EmbeddedSystemClass/Digital-Storage-Oscilloscope-2018/README.md

# Digital-Storage-Oscilloscope-2018
## BOM file can be checked via /WORKSHOP/813927_PCB_ryuan2/Project Outputs for DSO/
