EmbeddedSystemClass/Digital-Storage-Oscilloscope-2018/WORKSHOP/Workshop 1 - LTSpice.pdf

# Workshop 1 - LTSpice and Front End Filter Design

# Introduction

In this workshop we will cover:

- Circuit simulation using SPICE
- LTSPICE tutorial
- 1

st and 2

nd order filter low-pass active and passive filter design
- Step parameter variation of a simulation
- Op-amp based DC offset circuitry
- Basic LTSpice power analysis

Learning objectives:

- To create schematics within LTSPICE
- To become familiar with simulation within LTSPICE
- To understand the importance of circuit simulation in the electronics system design cycle
- To experiment with circuit design in a simulated environment
- To begin understanding how you will design the digital oscilloscope (DSO) front-end subsystem

# LTSPICE Fundamentals

Some of you will be familiar with most features of LTSPICE. If so, feel free to continue onto the next section. However, we recommend that you skim through the following LTSPICE tutorials:

1. Basic (https://www.allaboutcircuits.com/technical-articles/basic-circuit-simulation-with-ltspice/)
2. Intermediate (https://www.allaboutcircuits.com/technical-articles/intermediate-ltspice-tutorial/)
3. Advanced (https://learn.sparkfun.com/tutorials/getting-started-with-ltspice)

# Simulating Filters

## Part A: 1

## st Order Filters

Construct the following low-pass first order passive and active op-amp filters and perform AC analysis between 1Hz and 100MHz with 100 points per decade.

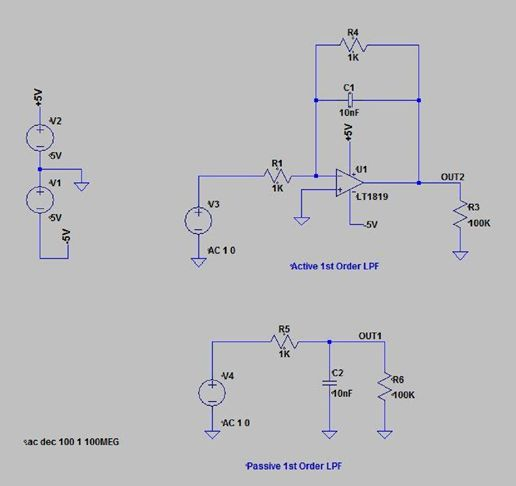
[picture p26: figure]

Figure 1: A Passive and Active 1st Order Low-pass Filter

### Questions

1. Given each filter has a -3dB roll-off frequency calculated by using the formulae found in appendix A, does the simulation agree with the value expected?
2. Does the passive and active frequency response differ and if so speculate why?
3. If the load is varied for both the active and passive circuit which circuit maintains greater gain stability?

## Part B: 2

## nd Order Filters

Using the steps outlined in appendix B and C design both a 2nd order Sallen-Key and Multiple-Feedback (MFB) op-amp filter design for simulation with LTSpice. The design parameters are as follows:

Roll-Off Frequency: f

-3dB = 100K
DC Gain: H0 | = 2
Use ⍺ = 1 | for the equations in appendix B and C. In lecture 5 you will cover filter design in detail.

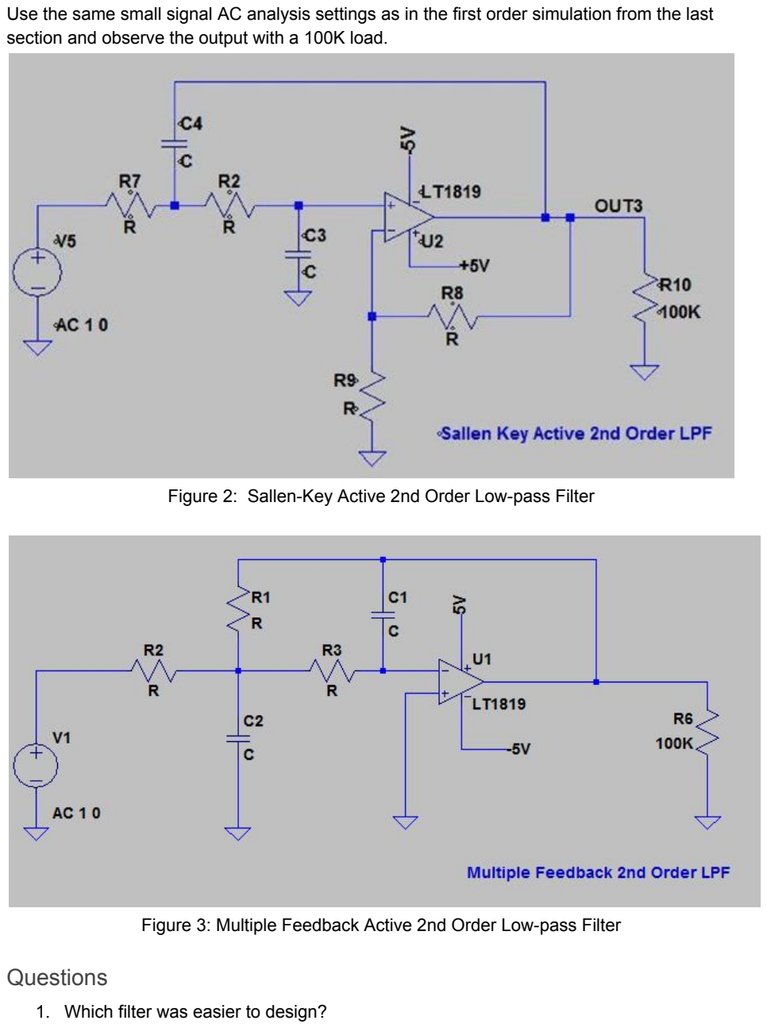
[picture p27: page 3]

Use the same small signal AC analysis settings as in the first order simulation from the last section and observe the output with a 100K load.

Figure 2: Sallen-Key Active 2nd Order Low-pass Filter

Figure 3: Multiple Feedback Active 2nd Order Low-pass Filter

### Questions

1. Which filter was easier to design?

2. Are the simulation results as expected?
3. If the capacitor C2 is varied in the MFB LPF what happens to the Q and corner frequency of the filter?
4. If the gain is varied for the Sallen-key 2nd order filter how is the frequency response changed?
5. If the load is varied for the MFB and Sallen-Key circuits which circuit maintains more stable frequency response and gain?

## Part C: Level Shifting Circuits

Now we seek to examine the performance of two level shifting circuits which achieve inverting and non-inverting DC voltage translation when an AC signal is applied to the input. Using a 2Vp-p input analyse the transient response at the output of each of the following circuits using varied DC voltage settings for sources V7 and V3.

Note the polarity of the DC reference is different for each level shifting topology.

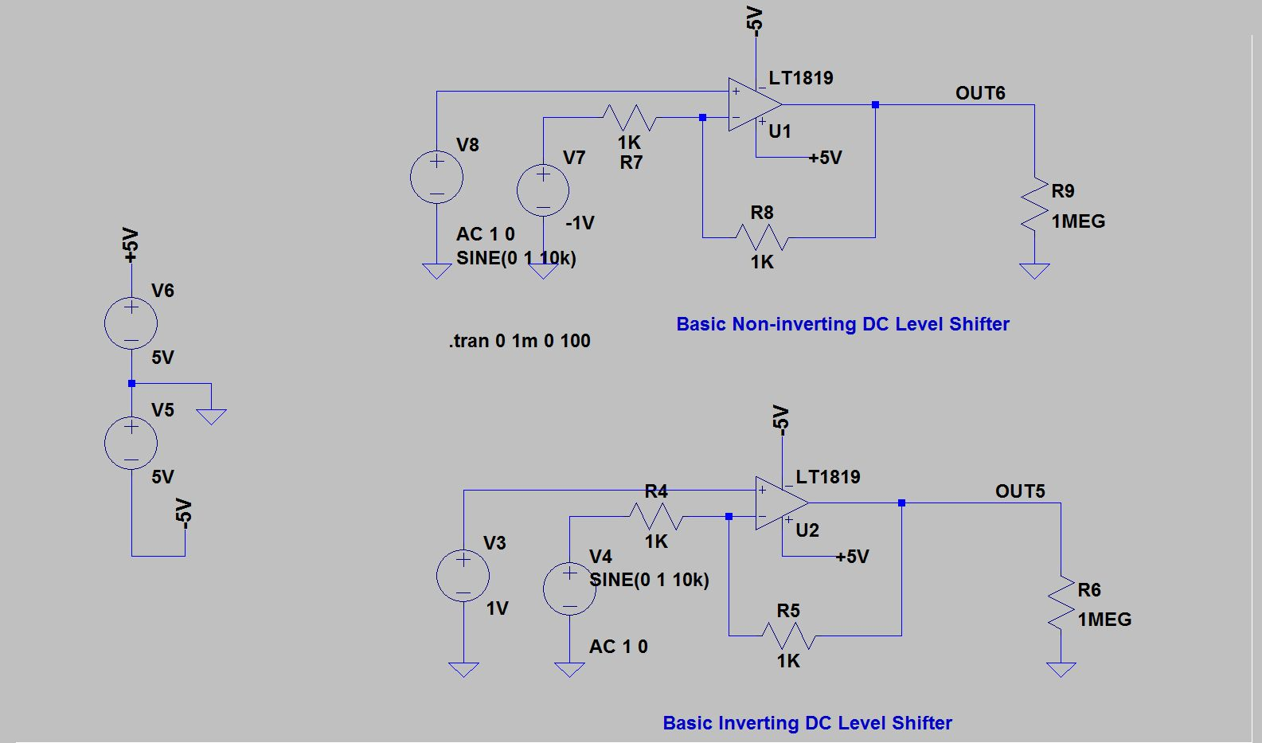
[picture p28: figure]

### Questions

1. What effect does changing the gain do to the level shifting function for a given DC reference voltage?
2. What change is observable for very low load resistance?
3. What is the output waveform for a pulse input signal? Does it differ from a pure sine?

4. What issues might arise if the DC reference is unable to sink high frequency currents through it?
5. How does the LT1819 simulation differ from an ideal opamp used in the same configuration?
6. Can you determine which component within the DC level shifter circuit is dissipating the greatest amount of power (as heat)
7. How might you reduce the power consumption of the level shifter circuit?

## Appendix A: 1

## st Order LPF Design

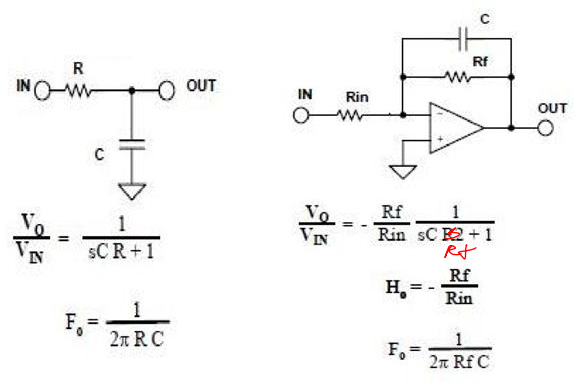
[picture p29: figure]

## Appendix B: 2

## nd Order Sallen-Key LPF Design

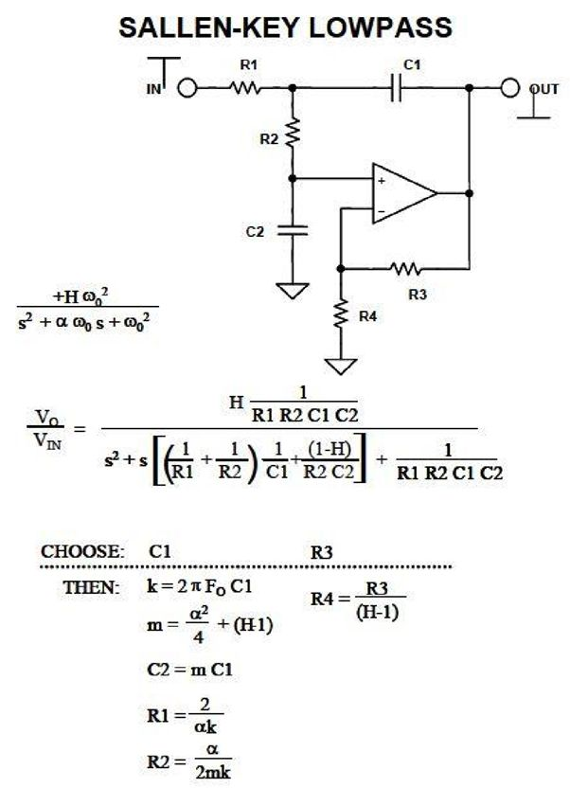
[picture p30: figure]

## Appendix C: 2

## nd Order Multiple Feedback LPF Design

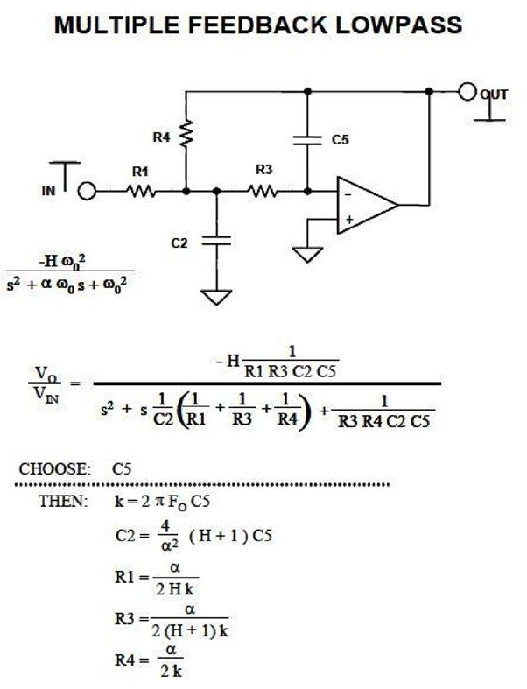
[picture p31: figure]
