EmbeddedSystemClass/Digital-Storage-Oscilloscope-2018/WORKSHOP/813927_PCB_ryuan2/Project Outputs for DSO/BOM/Bill of Materials-DSO.xlsx

Comment | Description | Designator | Footprint | LibRef | Manufacturer Part Number 1 | Quantity | Supplier Unit Price 1
5pf | Capacitor | C1, C3 | 0805C | C |  | 2
18pF | Capacitor | C2, C27, C28 | 0805C | C |  | 3
4.7pF | Capacitor | C4 | 0805C | C |  | 1
10uF | Capacitor | C5, C10, C11, C16, C48, C50 | 0805C | C |  | 6
100nF | Capacitor | C6, C8, C9, C12, C13, C14, C15, C17, C18, C19, C20, C21, C22, C23, C24, C25, C26, C29, C30, C31, C32, C33, C34, C35, C36, C37, C38, C39, C40, C41, C42, C43, C44, C45, C46, C47, C49, C51, C52, C53, C54, C55 | 0805C | C |  | 42
47pf | Capacitor | C7 | 0805C | C |  | 1
1uF | Capacitor | C56, C57 | 0805C | C |  | 2
Diode | Diode | D1, D2 | SOD-123 | D |  | 2
TX | Light Emitting Diode | D3, D5, D7 | 0805D-GREEN | LED GREEN | LTST-C171GKT (https://octopart-clicks.com/click/altium?sku=160-1423-1-ND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) | 3 | 0.34
RX | Light Emitting Diode | D4, D6 | 0805D-RED | LED RED | LHR974-LP-1 (https://octopart-clicks.com/click/altium?sku=475-1415-1-ND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) | 2 | 0.36
INPUT | BNC Straight | J1 | BNC_VERT | BNC | 5-1634503-1 (https://octopart-clicks.com/click/altium?sku=A97581-ND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) | 1 | 1.73
JTAG | JTAG_CON | J2 | BOXEDVERT10 | JTAG_CON | XG4C-1031 (https://octopart-clicks.com/click/altium?sku=OR896-ND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) | 1 | 1.04
USB | USB B Type Connector | J3 | USBPLUG | USBPLUG | 61729-0010BLF (https://octopart-clicks.com/click/altium?sku=609-1039-ND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) | 1 | 1.16
300mA | Inductor | L1, L2, L3, L4 | 0805 | I |  | 4
Header 3x2 | Header, 5-Pin | P1, P2 | HDR3x2 | Header 3x2 | M20-9980346 (https://octopart-clicks.com/click/altium?sku=952-2121-ND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) | 2 | 0.24
RTR025N03TL | N-Channel MOSFET | Q1, Q2, Q3 | SOT23 | MOSFET-N |  | 3
510k | Resistor | R1, R4 | 0805 | R |  | 2
1k | Resistor | R2, R3, R13, R16, R17, R18, R19, R20, R21, R22, R23, R24, R25, R26 | 0805 | R |  | 14
100K | Resistor | R5, R12 | 0805 | R |  | 2
100 | Resistor | R6, R7 | 0805 | R |  | 2
301 | Resistor | R8 | 0805 | R |  | 1
39 | Resistor | R9 | 0805 | R |  | 1
50 | Resistor | R10 | 0805 | R |  | 1
330 | Resistor | R11, R27 | 0805 | R |  | 2
10k | Resistor | R14, R15 | 0805 | R |  | 2
120 | Resistor | R28, R29, R30, R31 | 0805 | R |  | 4
RESET | Momentary Push Button Switch 1P 1T 2pins | S1, S2 | SPST PB SWITCH SMD | SW_PB_1P1T4 | PTS645SH50SMTR92LFS (https://octopart-clicks.com/click/altium?sku=CKN9085CT-ND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) | 2 | 0.26
INPUT | Pad | TP1, TP2, TP3 | Testpoin | Test Point |  | 3
-5 | Pad | TP4 | PIN 1.8mm | WIRE |  | 1
GND | Pad | TP5 | PIN 1.8mm | WIRE |  | 1
+5 | Pad | TP6 | PIN 1.8mm | WIRE |  | 1
LT1819 | OpAmp High Frequency Dual | U1, U2 | MSOP-8 | LT1819 | LT1819CMS8#PBF (https://octopart-clicks.com/click/altium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) | 2 | 3.28
74HC541 | (ADV) Octal Buffer, Line Driver | U3 | SOT163-1_N | 74HC541 | SN74HC541DWR (https://octopart-clicks.com/click/altium?sku=296-1202-1-ND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) | 1 | 0.65
ADS830E | 8-Bit, 60 MSPS ADC Single-Ended / Differential Input, Internal / External Reference and Programmble Input Range, -40 to 85 degC, 20-pin SOP (DBQ20), Green (RoHS & no Sb/Br) | U4 | TI-DBQ20_L | ADS830E | ADS830E (https://octopart-clicks.com/click/altium?sku=ADS830E-ND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) | 1 | 8.24
MAX9032 | Dual Comparator | U5 | SOIC-8 | MAX9032 | MAX9032ASA (https://octopart-clicks.com/click/altium?sku=MAX9032ASA-ND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) | 1
MCP4901 | DAC 8bit SPI | U6 | SOIC-8 | MCP4901 | MCP4901-E/SN (https://octopart-clicks.com/click/altium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) | 1 | 0.99
74HC590 | 8-Bit Binary Counter Register | U7, U8 | SOIC-16 | 74HC590 | SN74HC590ADR (https://octopart-clicks.com/click/altium?sku=296-17132-1-ND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) | 2 | 0.6
CY7C1019D | SRAM 128k x 8 | U9 | TSOP-32 | CY7C1019D | CY7C1019DV33-10ZSXI (https://octopart-clicks.com/click/altium?sku=428-1967-ND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) | 1 | 3.21
PT7C4511 | PLL Clock Multiplier | U10 | SOIC-8 | PT7C4511 | PT7C4511WEX (https://octopart-clicks.com/click/altium?sku=PT7C4511WEXDICT-ND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) | 1 | 1.5
ATMEGA16 | ATMEGA16 Microcontroller | U11 | QFP-48 | ATMEGA16 | ATMEGA16A-AU (https://octopart-clicks.com/click/altium?manufacturer=Microchip%20%2F%20Atmel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) | 1 | 2.83
FT232RL | USB to Serial bridge | U12 | SSOP-28 | FT232RL | FT232RL-REEL (https://octopart-clicks.com/click/altium?sku=768-1007-1-ND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) | 1 | 4.5
Si8421 | Dual Channel Digital Isolator Both Ways | U13 | SOIC-8 | Si8421 | SI8421AB-D-IS (https://octopart-clicks.com/click/altium?sku=336-1755-5-ND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) | 1 | 1.06
MCP1700T-3302E/MB | Low Quiescent Current LDO, 3-Pin SOT-89, Extended Temperature, Tape and Reel | U14 | SOT89 | MCP1700T | MCP1700T-3302E/MB (https://octopart-clicks.com/click/altium?sku=MCP1700T3302EMBCT-ND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) | 1 | 0.38
RD0505D | (ADV) DC to DC converter 5V in +-5V out | U15 | SIP_NMG | RD0505D | RD-0505D (https://octopart-clicks.com/click/altium?sku=945-1136-ND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) | 1 | 7.33
XC9536XL-10VQ44C | FastFLASH XC900XL, 3.3V High-Performance 36 Macrocell CPLD, 34 User I/Os, 44-Pin VQFP, Speed Grade 10, Commercial Grade | U16 | VQ44_L | XC9536XL-10VQG44C | XC9536XL-10VQG44C (https://octopart-clicks.com/click/altium?sku=122-1385-ND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) | 1 | 1.96
10Mhz | Crystal Oscillator | X1 | XTAL_FLAT_SMD | XTAL | 7A-10.000MAAJ-T (https://octopart-clicks.com/click/altium?sku=887-1080-1-ND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) | 1 | 0.88
