EmbeddedSystemClass/Digital-Storage-Oscilloscope-2018/WORKSHOP/CODE/DSO_2018_CODE/CPLD_Program/ESD_CPLD_2014 FINAL/CPLD_top_pad 04.08.2014.xlsx

Release 8.1i - Fit P.20131013
Copyright(c) 1995-2003 Xilinx Inc. All rights reserved
8- 4-2014 8:42PM
NOTE: This file is designed to be imported into a spreadsheet program
such as Microsoft Excel for viewing | printing and sorting. The comma ' | '
character is used as the data field separator.
This file is also designed to support parsing.
Input file: CPLD_top.ngd
output file: CPLD_top_pad.csv
Part type: xc9536xl
Speed grade: -10
Package: vq44
Pinout by Pin Number:
----- | ----- | ----- | ----- | ----- | ----- | ----- | ----- | ----- | -----
Pin Number | Signal Name | Pin Usage | Pin Name | Direction | IO Standard | IO Bank Number | {blank} | Slew Rate | Termination | {blank} | Voltage | Constraint
P1 | ENABLE | GCK | I/O/GCK3
P2 | FORCE | I | I/O | INPUT
P3 | RAM_READ_IN | I | I/O | INPUT
P4 | GND |  | GND
P5 | EDGE_SW | I | I/O | INPUT
P6 | RAM_READ_OUT | O | I/O | OUTPUT
P7 | RAM_FULL | I | I/O | INPUT
P8 | PGND |  | I/O
P9 | TDI |  | TDI
P10 | TMS |  | TMS
P11 | TCK |  | TCK
P12 | TRIGGER_IN | I | I/O | INPUT
P13 | PGND |  | I/O
P14 | PGND |  | I/O
P15 | VCC |  | VCCINT
P16 | PGND |  | I/O
P17 | GND |  | GND
P18 | PGND |  | I/O
P19 | PGND |  | I/O
P20 | PGND |  | I/O
P21 | PGND |  | I/O
P22 | PGND |  | I/O
P23 | PGND |  | I/O
P24 | TDO |  | TDO
P25 | GND |  | GND
P26 | VCC |  | VCCIO
P27 | PGND |  | I/O
P28 | FILL_COMPLETE | O | I/O | OUTPUT
P29 | COUNTER_CLK | O | I/O | OUTPUT
P30 | ENABLE_COUNT | O | I/O | OUTPUT
P31 | CLEAR_COUNT | O | I/O | OUTPUT
P32 | PGND |  | I/O
P33 | PGND |  | I/O/GSR
P34 | PGND |  | I/O/GTS2
P35 | VCC |  | VCCINT
P36 | PGND |  | I/O/GTS1
P37 | PGND |  | I/O
P38 | PGND |  | I/O
P39 | PGND |  | I/O
P40 | PGND |  | I/O
P41 | ADC_CLK | O | I/O | OUTPUT
P42 | PGND |  | I/O
P43 | SLOW_CLK | I | I/O/GCK1 | INPUT
P44 | FAST_CLK | I | I/O/GCK2 | INPUT
To preserve the pinout above for future design iterations in
Project Navigator simply execute the (Lock Pins) process
located under the (Implement Design) process in a toolbox named
(Optional Implementation Tools) or invoke PIN2UCF from the
command line. The location constraints will be written into your
specified UCF file
