EmbeddedSystemClass/Digital-Storage-Oscilloscope-2018/WORKSHOP/TESTIMG/Black_and_White_Yin_Yang_Symbol.bmp

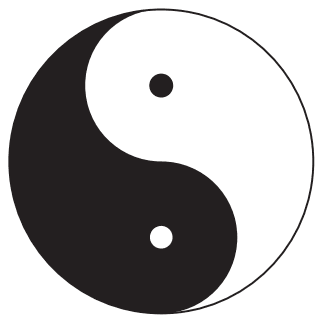
WORKSHOP/TESTIMG/Black_and_White_Yin_Yang_Symbol.bmp
