EmbeddedSystemClass/Digital-Storage-Oscilloscope-2018/WORKSHOP/TESTIMG/super.bmp

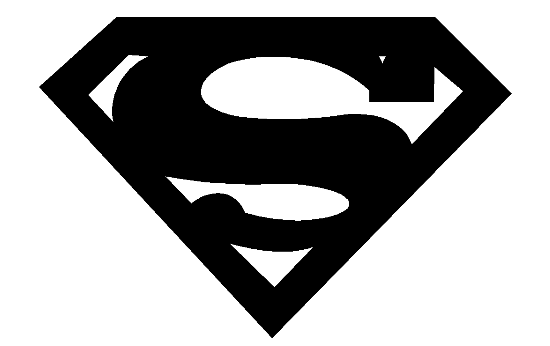
WORKSHOP/TESTIMG/super.bmp
