EmbeddedSystemClass/Digital-Storage-Oscilloscope-2018/WORKSHOP/TESTIMG/YINYANG.bmp

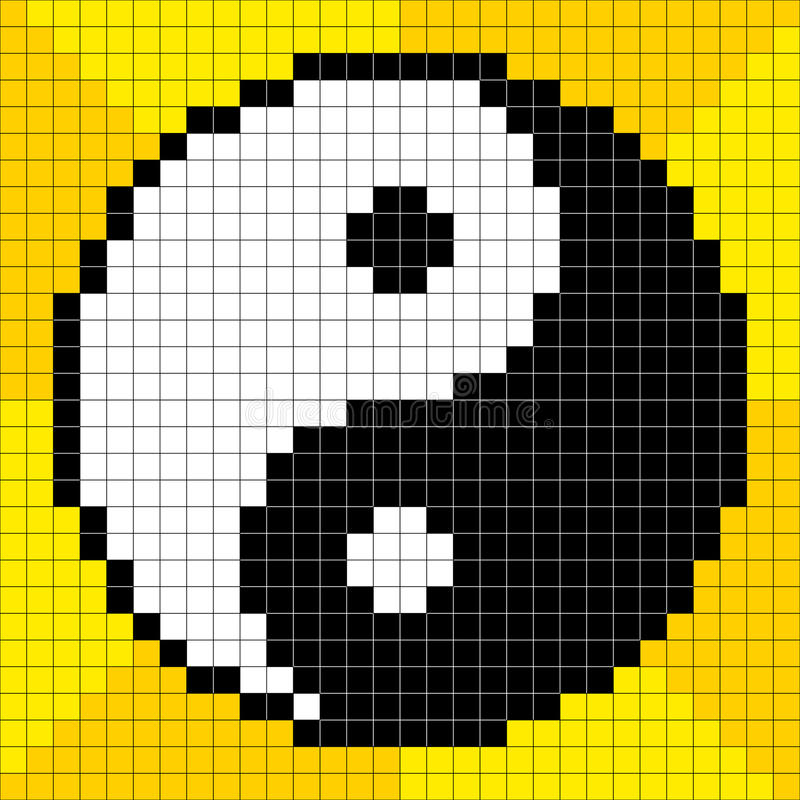
WORKSHOP/TESTIMG/YINYANG.bmp
