EmbeddedSystemClass/Digital-Storage-Oscilloscope-2018/WORKSHOP/Requirement/Components - Passive - Sheet1.pdf

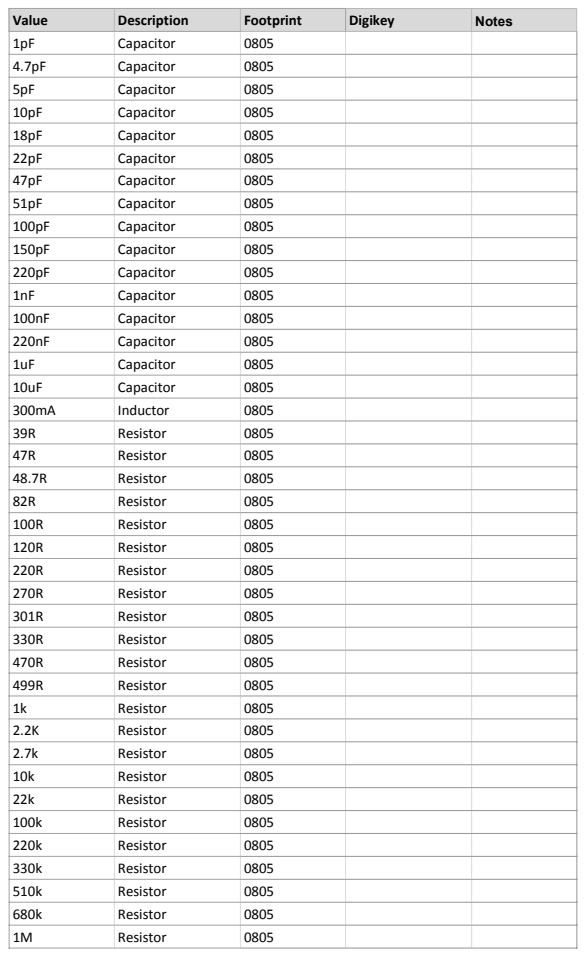
[picture p65: page 1]
Value; Description; Footprint; Digikey; Notes; Capacitor; Inductor; Resistor

2.2M | Resistor | 0805
200 Ohm | Variable Resistor | 33198P | 3319P-201-ND | 1 Per student
500 Ohm | Variable Resistor | 33198P | 3319P-1-501-ND | 1 Per student
4.7 kOhm | Variable Resistor | 33198P | 3319P-1-472-ND | 1 Per student
1 Mohm | Variable Resistor | 33198P | 3319P-1-105-ND | 1 Per student
