EmbeddedSystemClass/Digital-Storage-Oscilloscope-2018/WORKSHOP/BlockDiagram2_withCPLD (1).pdf

BNC | Clamp | Scaling
Network | Buffer | Gain | Offset

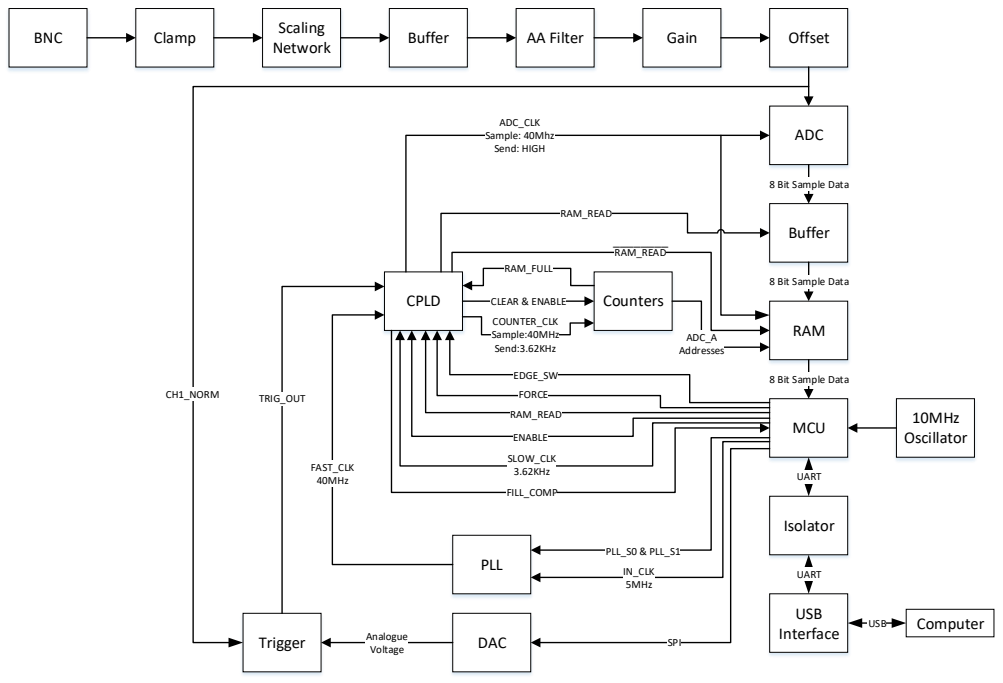
[picture p68: page 1]
ADC; Buffer; AA Filter; RAM; MCU; Isolator; USB; Interface Trigger; DAC; PLL; CPLD; Counters; UART; Analogue; Voltage; SPI; IN_CLK 5MHz; ADC_A Addresses; TRIG_OUT; FAST_CLK 40MHz; ADC_CLK Sample: 40Mhz Send: HIGH; RAM_READ; FILL_COMP; SLOW_CLK 3.62KHz; ENABLE; FORCE; EDGE_SW; Computer; CLEAR & ENABLE; COUNTER_CLK Sample:40MHz Send:3.62KHz; RAM_FULL; PLL_S0 & PLL_S1; CH1_NORM; 10MHz Oscillator

8 Bit Sample Data

1

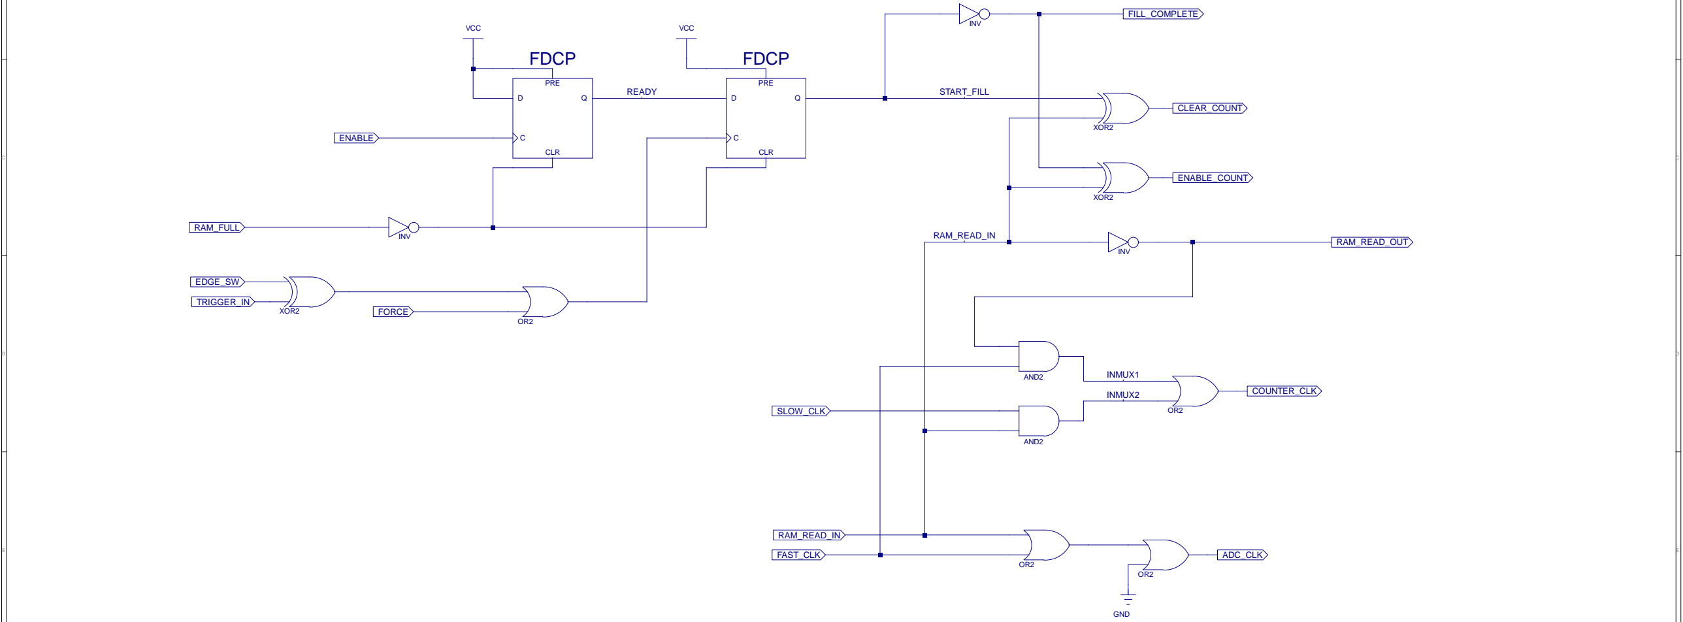
[picture p69: figure]
FDCP; PRE; CLR; VCC; READY; INV; XOR2; START_FILL; AND2; INMUX1; INMUX2; GND; RAM_READ_IN; ENABLE; FORCE; RAM_READ_OUT; CLEAR_COUNT; ENABLE_COUNT; FILL_COMPLETE; COUNTER_CLK; ADC_CLK; FAST_CLK; SLOW_CLK; RAM_FULL; EDGE_SW; TRIGGER_IN

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
A | A
B | B
F | F

## UoM ELEN90053 DSO CPDL Design
