EmbeddedSystemClass/Digital-Storage-Oscilloscope-2018/WORKSHOP/20180909/DSO.PDF

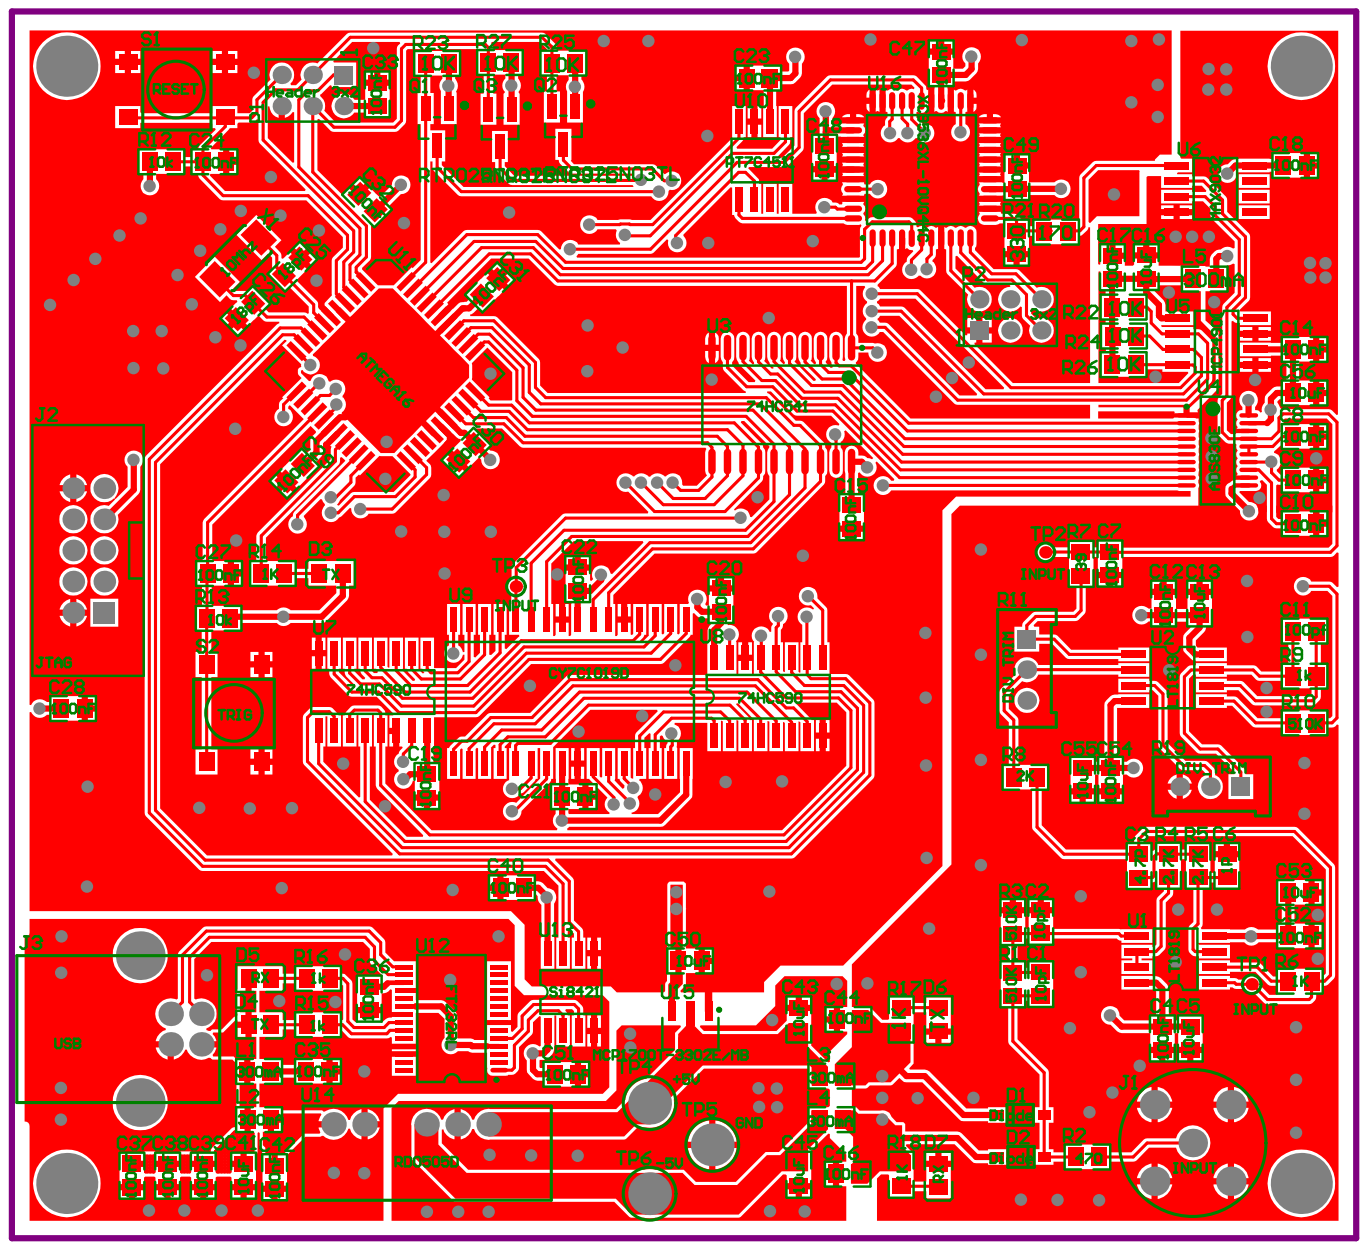
[picture p70: page 1]

Board S
