EmbeddedSystemClass/Digital-Storage-Oscilloscope-2018/WORKSHOP/Workshop1/FirstOrderFilter.asc

C1: cap; 10nF
C2: cap; 10nF
R1: res; 1K
R2: res; 1K
R3: res; 100K
R4: res; 1K
R5: res; 100k
U1: LT1819
V1: voltage; ""; AC 1.0
V2: voltage; 5V
V3: voltage; 5V
V4: voltage; ""; AC 1 0
Named nets: 0, +5V, -5V, OUT2, OUT1
Active 1st Order LPF
Passive 1st LPF
.ac dec 100 1 100Meg
