EmbeddedSystemClass/Digital-Storage-Oscilloscope-2018/WORKSHOP/Workshop1/SecondOrder2.asc

C5: cap; 10nf
C6: cap; 120nF
R7: res; 79.578
R11: res; 39.78
R12: res; 26.53
R13: res; 100K
U3: LT1819
V2: voltage; 5
V3: voltage; 5
V6: voltage; ""; AC 1 0
Named nets: 0, +5V, -5V
Multiple Feedback Active 2nd Order Low-pass Filter
.ac dec 100 1 100meg
