EmbeddedSystemClass/Digital-Storage-Oscilloscope-2018/WORKSHOP/Workshop1/TEST.asc

C1: cap; 10pf
C2: cap; 10pf
R1: res; 500k
R2: res; 500k
V1: voltage; ""; AC 1 0
Named nets: out_CLAMP, Out_div, 0
Buffer
.ac dec 100 10 30Meg
