EmbeddedSystemClass/Digital-Storage-Oscilloscope-2018/WORKSHOP/Workshop1/TEST_LPF.asc

C1: cap; 4.7pf
C2: cap; 18pf
R1: res; 470
R2: res; 470
R3: res; 100k
R4: res; 100
U1: LT1819
V1: voltage; ""; AC 1 0
V2: voltage; 5
V3: voltage; 5
Named nets: 0, -5V, +5V, OUT3, Out_buf
.ac dec 100 1000 100Meg
