EmbeddedSystemClass/Digital-Storage-Oscilloscope-2018/WORKSHOP/Lodge/Sch_813927.asc

C1: cap; 18pf
C2: cap; 4.7pf
C3: cap; 5pf
C4: cap; 5pf
C5: cap; 47pf
C6: cap; 0.1µF
C8: cap; 0.1µF
D1: diode; 1N4148
D2: diode; 1N4148
R1: res; 1k
R2: res; 1k
R3: res; 100
R4: res; 0
R5: res; 510k
R6: res; 510k
R7: res; 301
R8: res; 100
R9: res; 39
R10: res; 100k
R11: res; 330
R12: res; 50
R13: res; 100k
R14: res; 1k
U1: LT1819
U2: LT1819
U3: LT1819
U4: LT1819
V1: voltage; SINE(0 9 10Meg); AC 1 1; Rser=560
V2: voltage; 5
V3: voltage; 5
V4: voltage; 2
Named nets: 0, +5V, -5V, OUT3, out_CLAMP, Out_div, Out_buf, OUT
Sallen Key Active 2nd Order LPF
Input Protection
.tran 1000ns
Buffer
Gain stage and Level shifting filter
Compensate the impedance of the optical amp
