EmbeddedSystemClass/Digital-Storage-Oscilloscope-2018/(list of files, drawings)

Other design files:
WORKSHOP/813927_PCB_ryuan2/DSO.PrjPCB
WORKSHOP/813927_PCB_ryuan2/DSO_ADC.SchDoc
WORKSHOP/813927_PCB_ryuan2/DSO_Clock.SchDoc
WORKSHOP/813927_PCB_ryuan2/DSO_Control.SchDoc
WORKSHOP/813927_PCB_ryuan2/DSO_Counters.SchDoc
WORKSHOP/813927_PCB_ryuan2/DSO_CPLD.SchDoc
WORKSHOP/813927_PCB_ryuan2/DSO_Front.SchDoc
WORKSHOP/813927_PCB_ryuan2/DSO_IO.SchDoc
WORKSHOP/813927_PCB_ryuan2/DSO_Power.SchDoc
WORKSHOP/813927_PCB_ryuan2/DSO_RAM.SchDoc
WORKSHOP/813927_PCB_ryuan2/DSO_Top.SchDoc
WORKSHOP/813927_PCB_ryuan2/DSO_Trig.SchDoc
WORKSHOP/20180909/DSO.PcbLib
WORKSHOP/20180909/DSO.PrjPCB
WORKSHOP/20180909/DSO.SCHLIB
WORKSHOP/20180909/DSO_ADC.SchDoc
WORKSHOP/20180909/DSO_Clock.SchDoc
WORKSHOP/20180909/DSO_Control.SchDoc
WORKSHOP/20180909/DSO_Counters.SchDoc
WORKSHOP/20180909/DSO_CPLD.SchDoc
WORKSHOP/20180909/DSO_Front.SchDoc
WORKSHOP/20180909/DSO_IO.SchDoc
WORKSHOP/20180909/DSO_Power.SchDoc
WORKSHOP/20180909/DSO_RAM.SchDoc
WORKSHOP/20180909/DSO_Top.SchDoc
WORKSHOP/20180909/DSO_Trig.SchDoc
WORKSHOP/20180909/RPOT.PcbLib
WORKSHOP/20180909/RPOT.SchLib
WORKSHOP/DSO_Altium_Template_2018_v3/DSO.PcbLib
WORKSHOP/DSO_Altium_Template_2018_v3/DSO.PrjPCB
WORKSHOP/DSO_Altium_Template_2018_v3/DSO.SCHLIB
WORKSHOP/DSO_Altium_Template_2018_v3/DSO_ADC.SchDoc
WORKSHOP/DSO_Altium_Template_2018_v3/DSO_Clock.SchDoc
WORKSHOP/DSO_Altium_Template_2018_v3/DSO_Control.SchDoc
WORKSHOP/DSO_Altium_Template_2018_v3/DSO_Counters.SchDoc
WORKSHOP/DSO_Altium_Template_2018_v3/DSO_CPLD.SchDoc
WORKSHOP/DSO_Altium_Template_2018_v3/DSO_Front.SchDoc
WORKSHOP/DSO_Altium_Template_2018_v3/DSO_IO.SchDoc
WORKSHOP/DSO_Altium_Template_2018_v3/DSO_Power.SchDoc
WORKSHOP/DSO_Altium_Template_2018_v3/DSO_RAM.SchDoc
WORKSHOP/DSO_Altium_Template_2018_v3/DSO_Top.SchDoc
WORKSHOP/DSO_Altium_Template_2018_v3/DSO_Trig.SchDoc
WORKSHOP/DSO_Altium_Template_2018_v3/RPOT.PcbLib
WORKSHOP/DSO_Altium_Template_2018_v3/RPOT.SchLib
WORKSHOP/Lodge/DSO.PrjPCB
WORKSHOP/Lodge/DSO_ADC.SchDoc
WORKSHOP/Lodge/DSO_Clock.SchDoc
WORKSHOP/Lodge/DSO_Control.SchDoc
WORKSHOP/Lodge/DSO_Counters.SchDoc
WORKSHOP/Lodge/DSO_CPLD.SchDoc
WORKSHOP/Lodge/DSO_Front.SchDoc
WORKSHOP/Lodge/DSO_IO.SchDoc
WORKSHOP/Lodge/DSO_Power.SchDoc
WORKSHOP/Lodge/DSO_RAM.SchDoc
WORKSHOP/Lodge/DSO_Top.SchDoc
WORKSHOP/Lodge/DSO_Trig.SchDoc
WORKSHOP/MyDesign/PCB1.PcbDoc
WORKSHOP/MyDesign/PCB_Project1.PrjPCB
WORKSHOP/MyDesign/Sheet1.SchDoc
WORKSHOP/MyDesign/Sheet2.SchDoc
